Yavuz-Kagan-Yadigar/Walkie-Textie/X2_KIdLTiZDeG.png

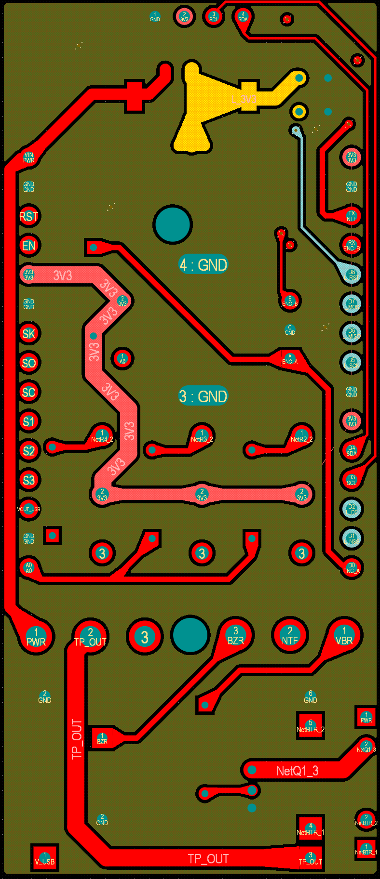
X2_KIdLTiZDeG.png
