Yavuz-Kagan-Yadigar/Walkie-Textie/X2_CgZ9uICAGX.png

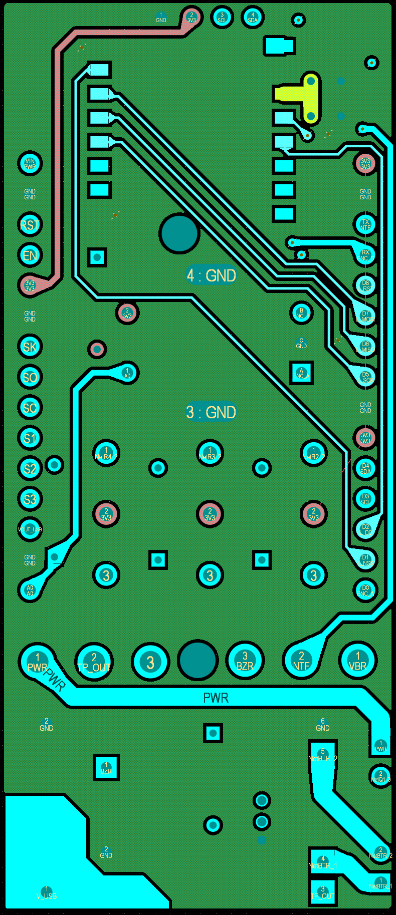
X2_CgZ9uICAGX.png
