Yavuz-Kagan-Yadigar/Walkie-Textie/README.md

# Walkie-Textie
LoRa RA01 Based Low Cost Walkie-Textie
https://youtu.be/EXD1s3Uqais

English is below

Şebekeden bağımsız iletişimin önemini 6 Şubat depreminde deneyimledikten sonra düşük maliyetli ve yapımı kolay bir telsiz tasarlamaya ve açık kaynak olarak paylaşmaya karar verdim.

Toplam maliyeti 500TL ve lehimlemesi kolay olması için delikten geçmeli (TH) veya büyük SMD komponentler seçtim.

Teorik menzili 10Km olsa da şehir içinde test ettiğimde 1,5Km menzile ulaşabildim. Farklı ayarlar ve ayarlanmış bir anten ile menzil arttırılabilir, kodda ayarları açıkladım. 

Tabi ki 433mhz 20dB enkazdan geçemez ancak sivil halk arasındaki iletişim yükünü şebekeden alarak iletişimi yeninden sağlayabilir.

Maliyeti düşük tutmak amacıyla enkoderla harf seçmeye dayalı bir giriş sistemi tasarladım.

3D,PCB ve kod dosyaları: https://github.com/Yavuz-Kagan-Yadigar/Walkie-Textie

---------------------------------------------------------------------------------------------------
After experiencing the importance of off-grid communication during the February 6th earthquake, I decided to design a low-cost, easy-to-build radio and share it as open source.

The total cost is around 500₺, and to make soldering easier, I chose through-hole (TH) or large SMD components.

Although its theoretical range is 10 km, in urban testing I was able to reach a range of 1.5 km. The range can be extended with different settings and a tuned antenna, I’ve explained the configuration details in the code.

Of course, a 433 MHz 20 dB signal can't penetrate debrish, but it can offload some of the communication from the main network and help re-establish contact among civilians.

To keep costs down, I designed an input system based on selecting letters using an encoder.

3D, PCB, and code files: https://github.com/Yavuz-Kagan-Yadigar/Walkie-Textie
