Yavuz-Kagan-Yadigar/Walkie-Textie/Fusion360_rX4GBJ2rvt.png

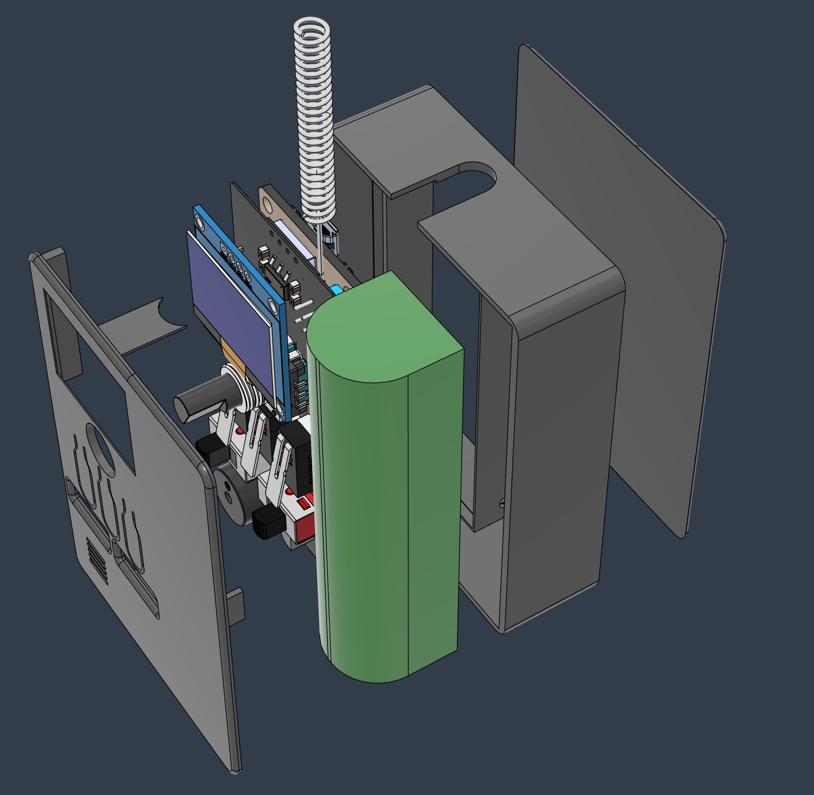
Fusion360_rX4GBJ2rvt.png
