Yavuz-Kagan-Yadigar/Walkie-Textie/X2_lCyN5deRnM.png

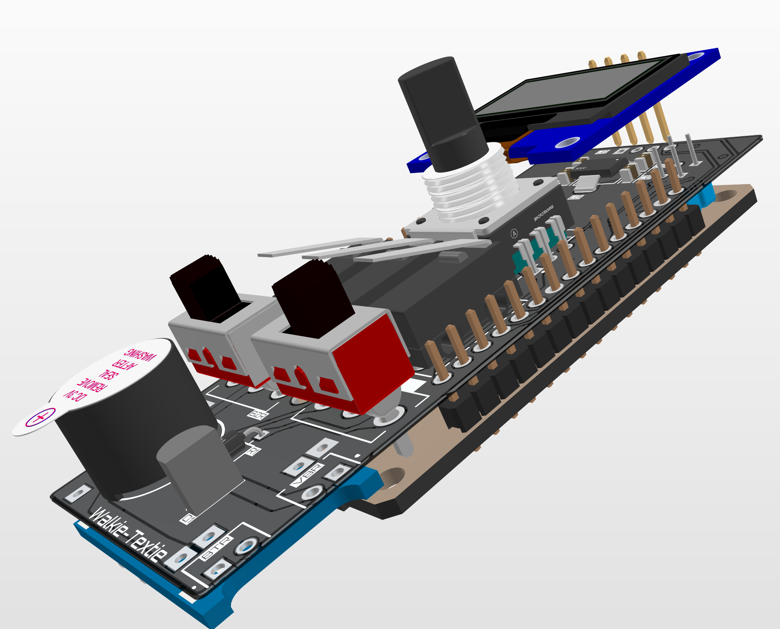
X2_lCyN5deRnM.png
