Yavuz-Kagan-Yadigar/Walkie-Textie/X2_SBtA5Ge9f7.png

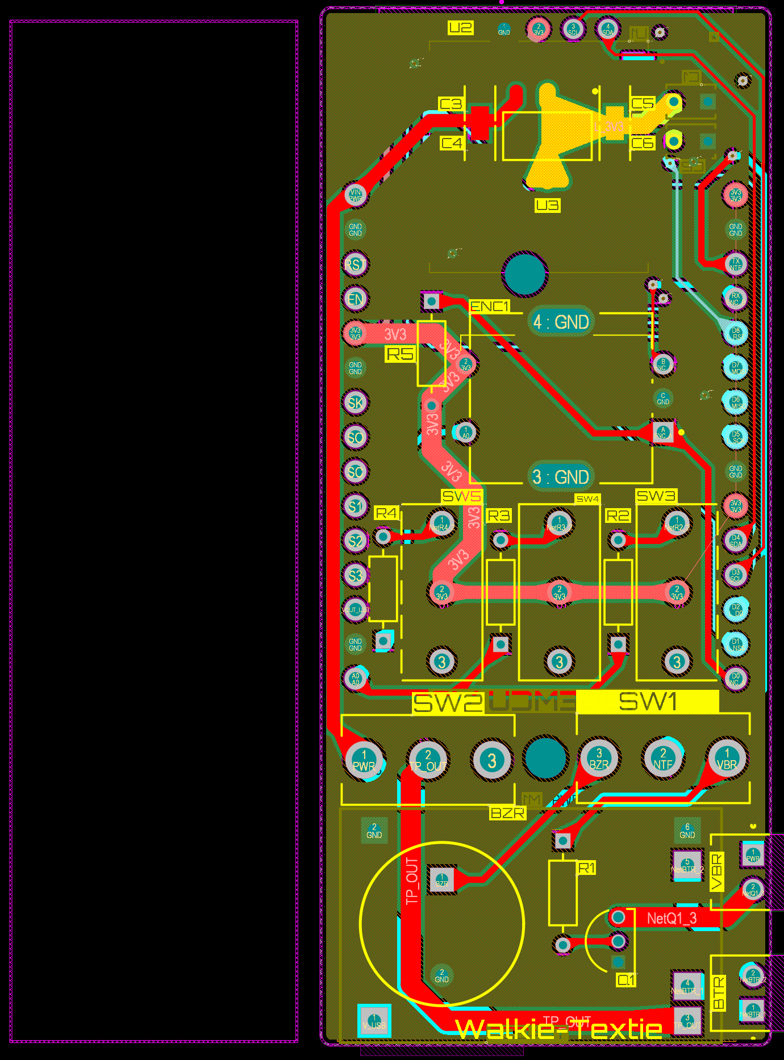
X2_SBtA5Ge9f7.png
