Yavuz-Kagan-Yadigar/Walkie-Textie/Walkie-Textie_schematic.pdf

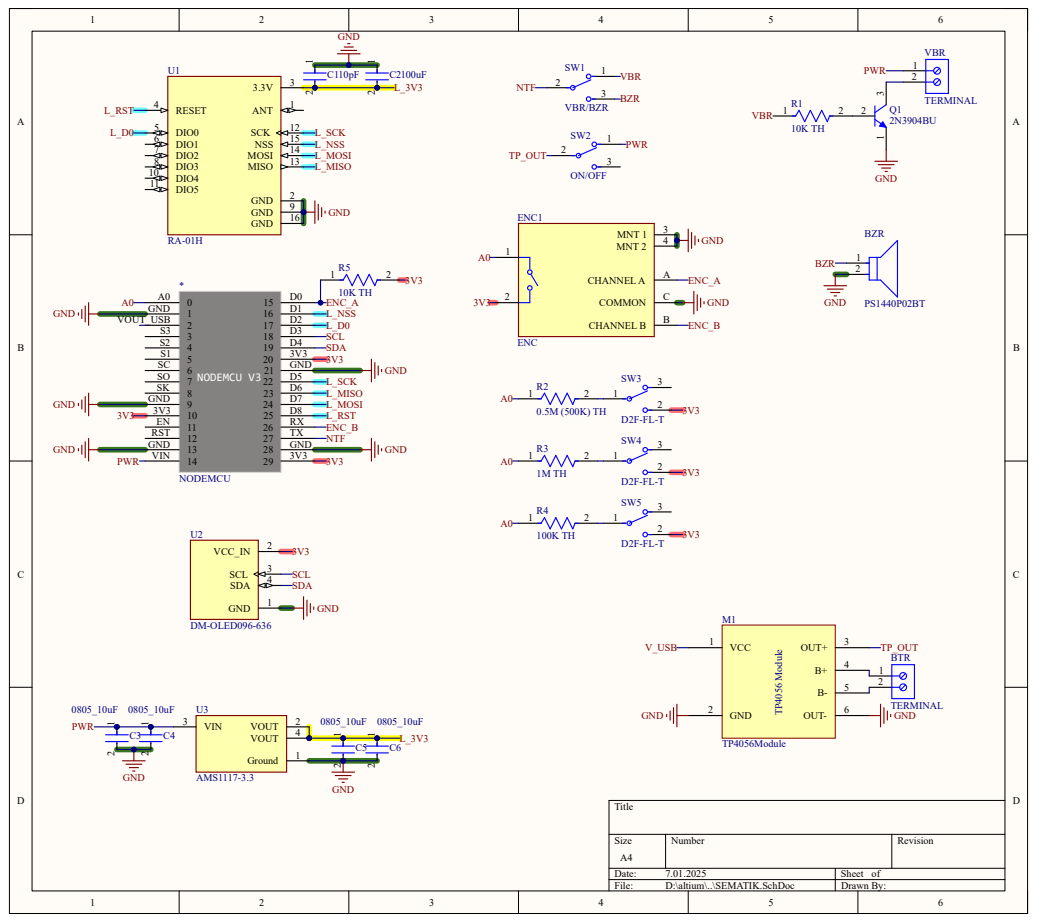
[picture p6: page 1]
